DystopiaNow/UVCLamps_chambers/IMG_20200504_171959.jpg

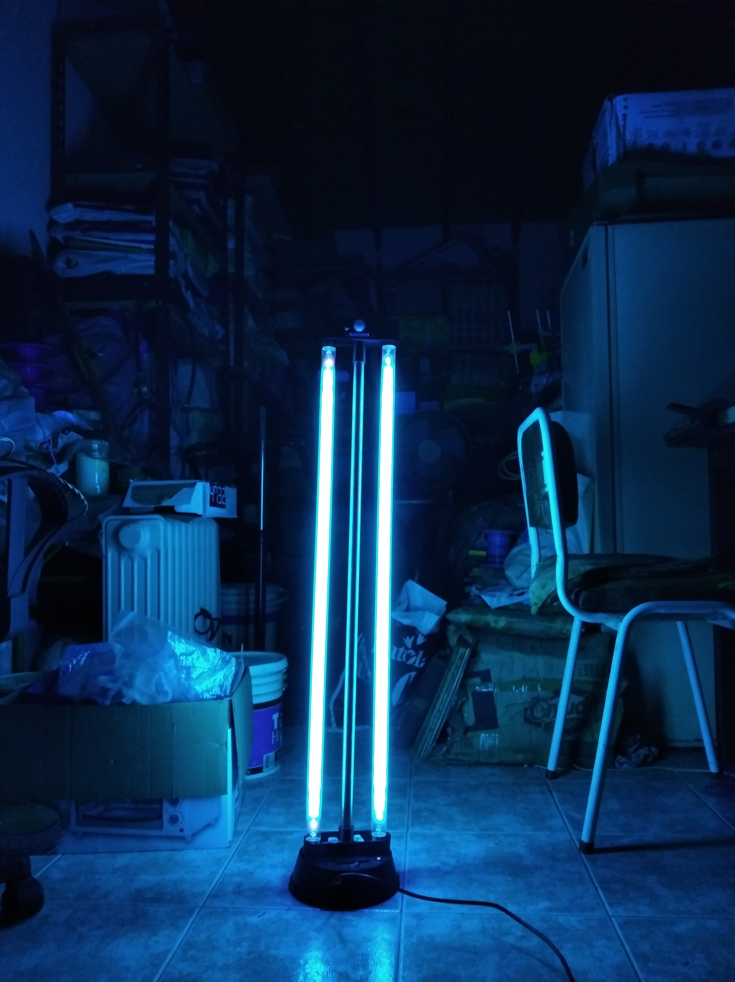
IMG_20200504_171959.jpg
