DystopiaNow/UVCLamps_chambers/UVCChamber1/Captura de pantalla 2020-05-08 20.49.10.png

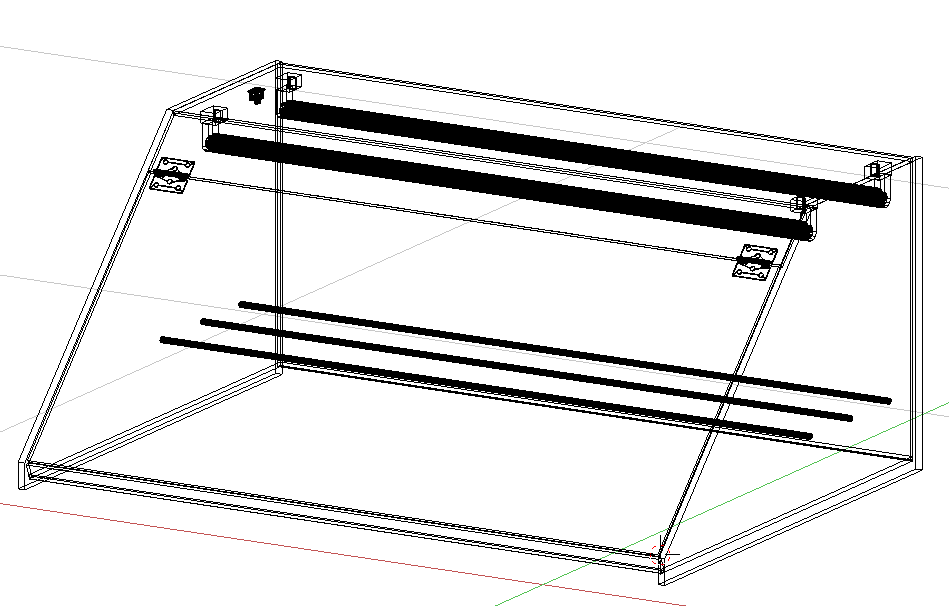
UVCChamber1/Captura de pantalla 2020-05-08 20.49.10.png
