DystopiaNow/UVCLamps_chambers/UVCChamber1/Captura de pantalla 2020-05-09 03.30.54.png

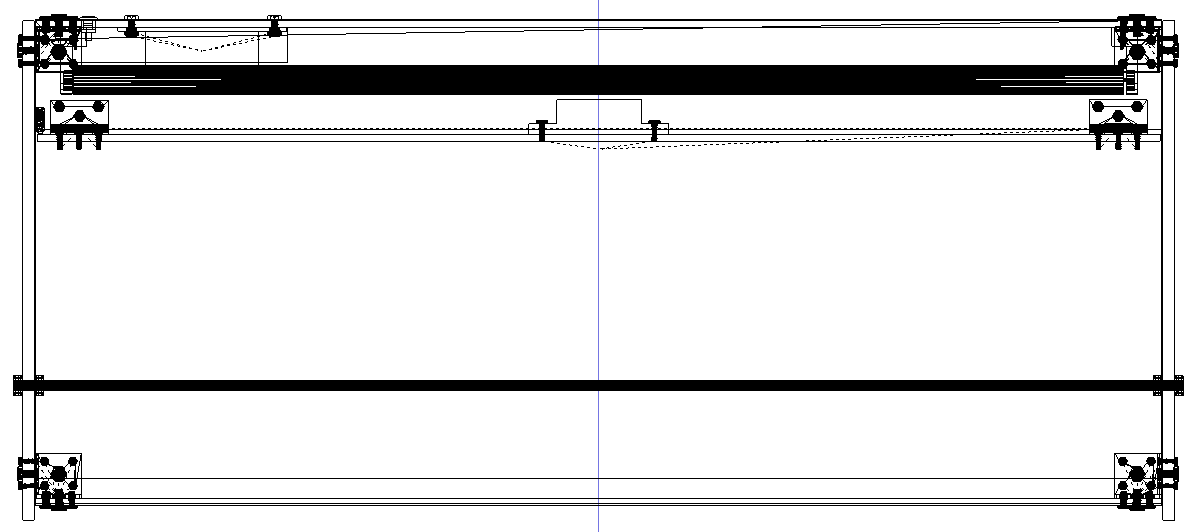
UVCChamber1/Captura de pantalla 2020-05-09 03.30.54.png
