DystopiaNow/UVCLamps_chambers/UVCChamber1/UVC_chamber1.png

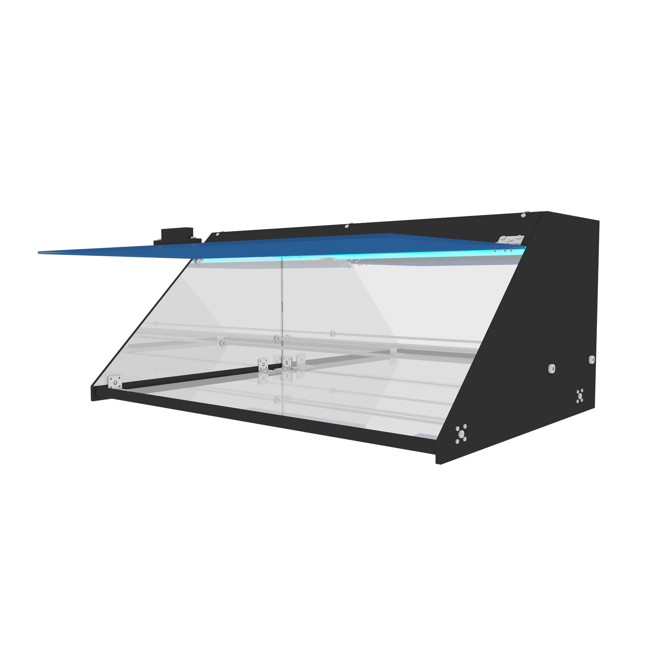
UVCChamber1/UVC_chamber1.png
