DystopiaNow/UVCLamps_chambers/UVCChamber1/UVC_chamber2.png

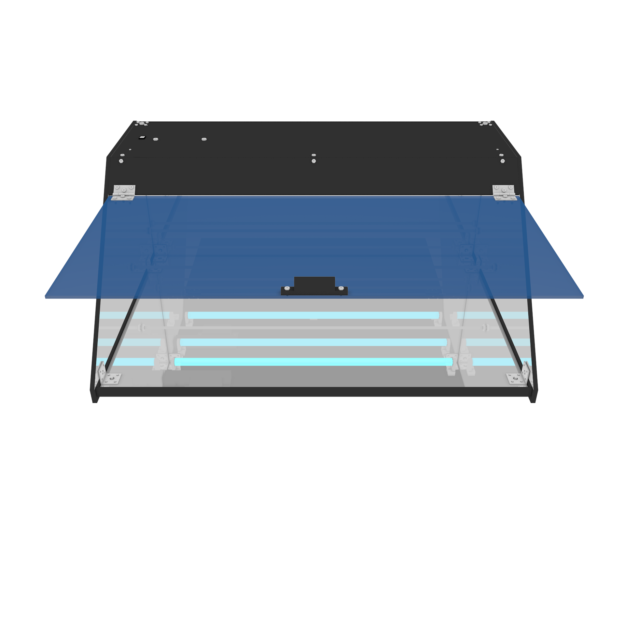
UVCChamber1/UVC_chamber2.png
