DystopiaNow/UVCLamps_chambers/UVCChamber1/UVC_chamber3.png

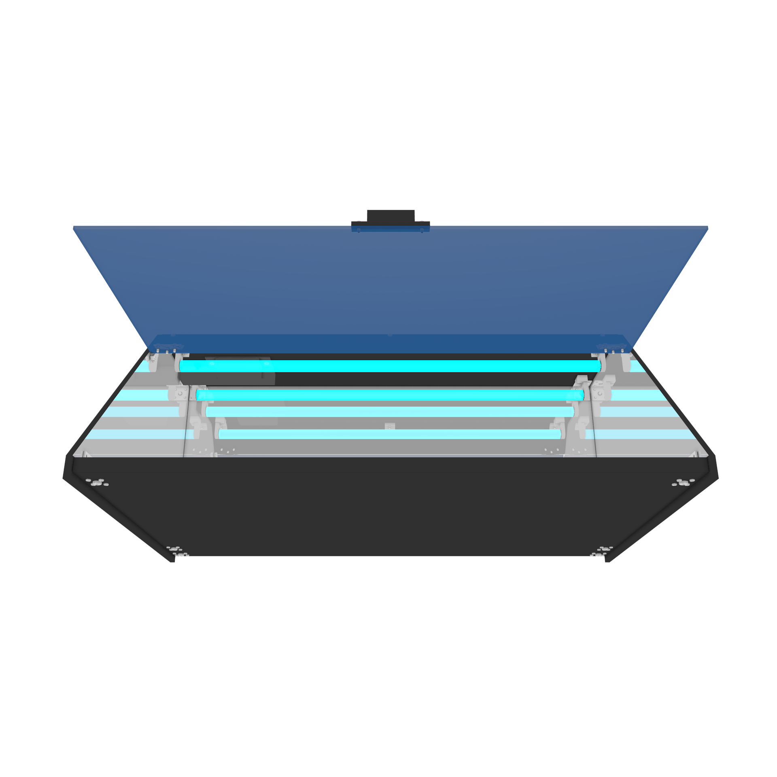
UVCChamber1/UVC_chamber3.png
