DystopiaNow/UVCLamps_chambers/UVCChamber1/UVC_chamber4.png

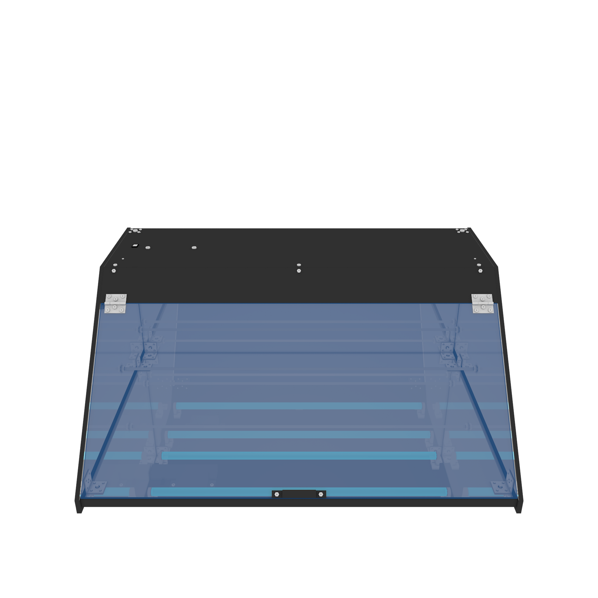
UVCChamber1/UVC_chamber4.png
