DystopiaNow/UVCLamps_chambers/UVCChamber1/UVC_chamber5.png

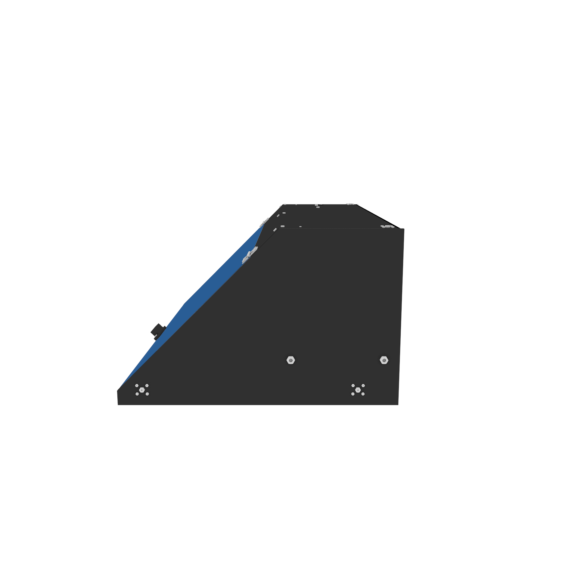
UVCChamber1/UVC_chamber5.png
