DystopiaNow/UVCLamps_chambers/UVCChamber1/UVC_chamber6.png

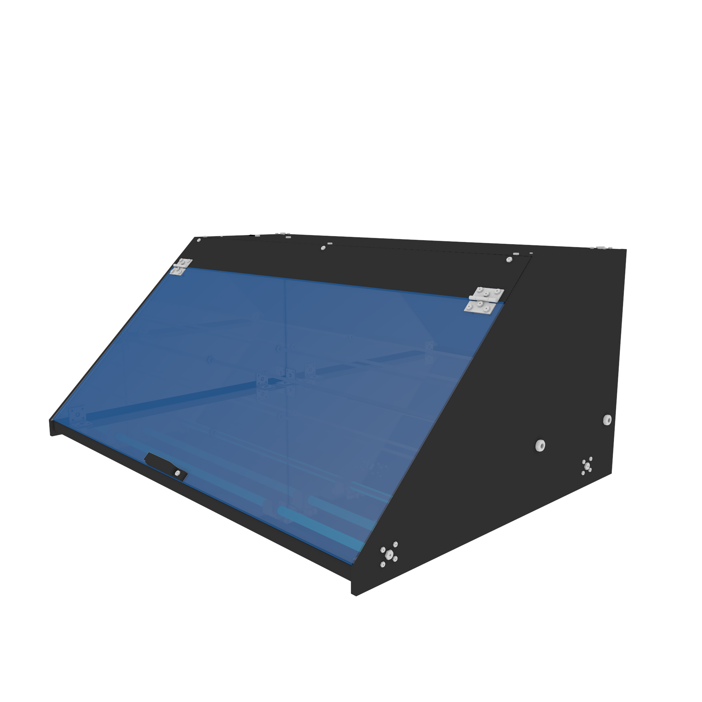
UVCChamber1/UVC_chamber6.png
