DystopiaNow/UVCLamps_chambers/UVCChamber1/UVC_chamber7.png

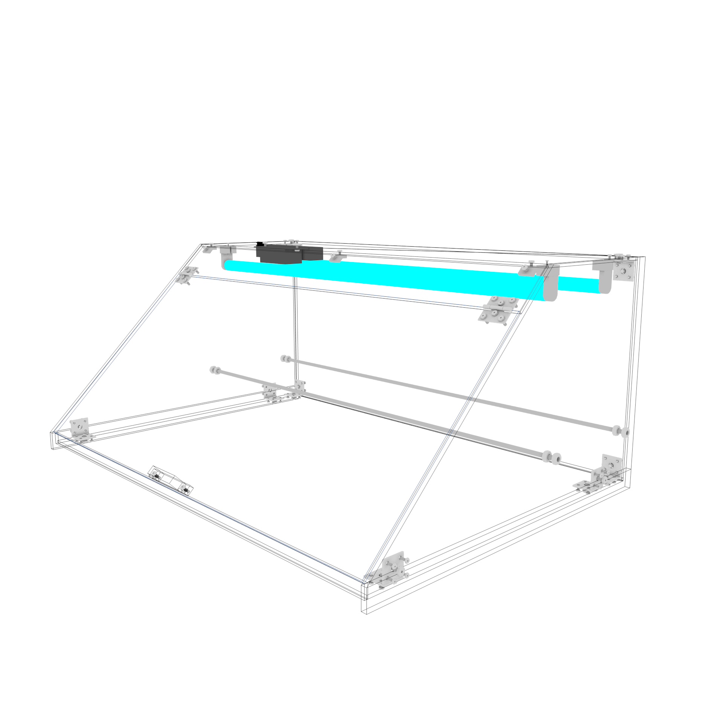
UVCChamber1/UVC_chamber7.png
