DystopiaNow/UVCLamps_chambers/UVCChamber1/UVC_chamber8.png

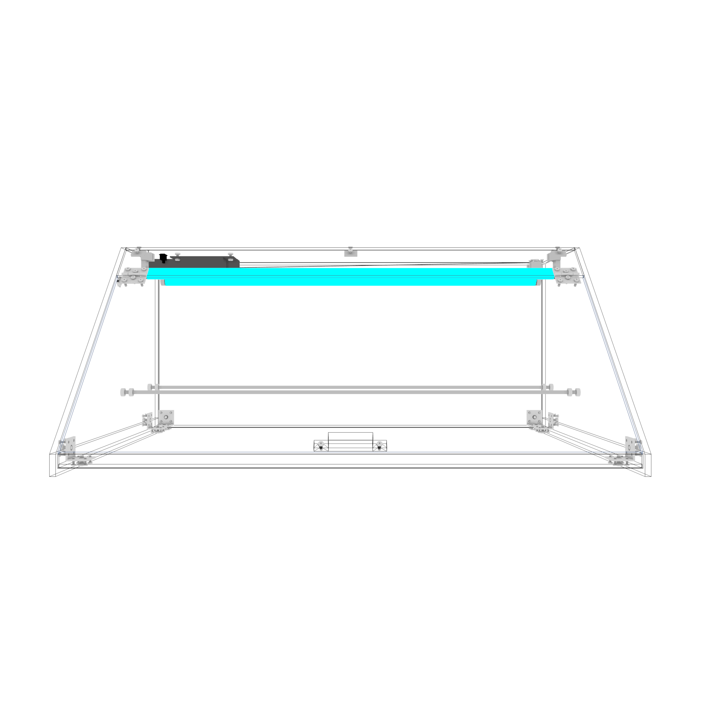
UVCChamber1/UVC_chamber8.png
