DystopiaNow/UVCLamps_chambers/UVCChamber1/UVC_chamber9.png

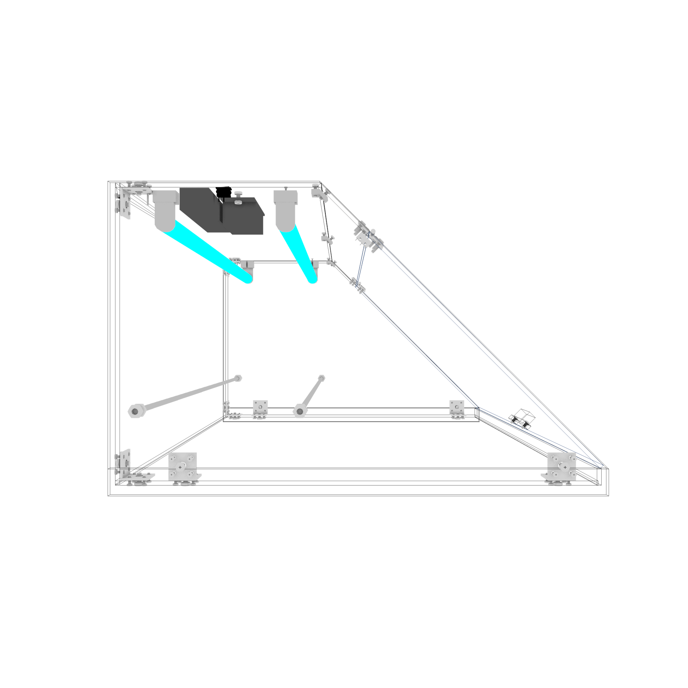
UVCChamber1/UVC_chamber9.png
