DystopiaNow/UVCLamps_chambers/UVCChamber1/UVC_chamber10.png

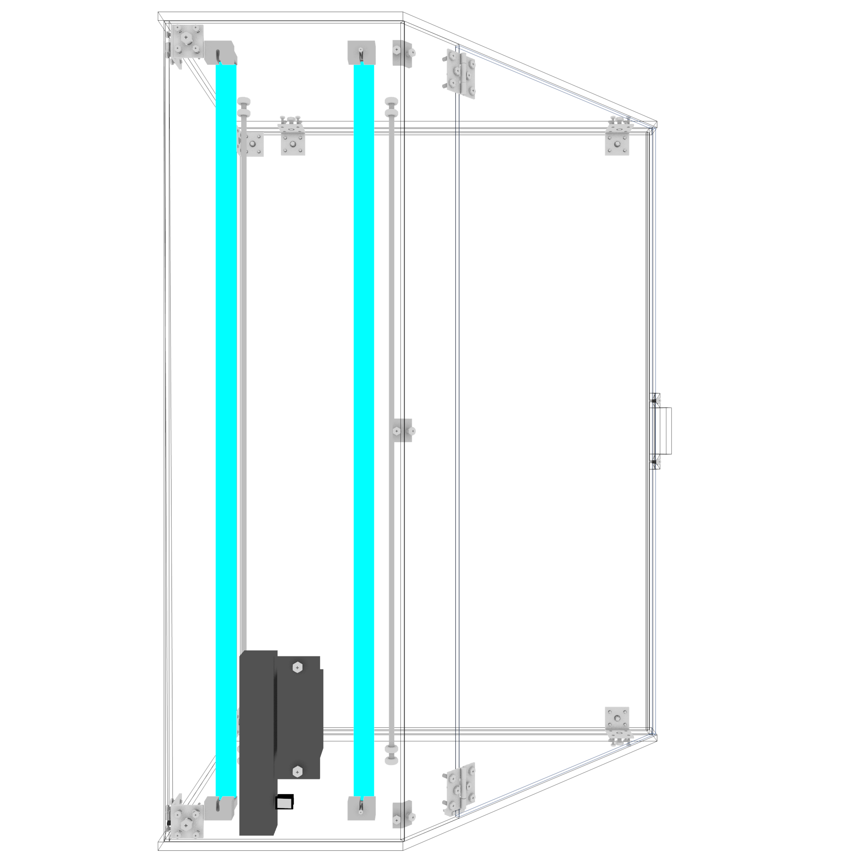
UVCChamber1/UVC_chamber10.png
