DystopiaNow/UVCLamps_chambers/UVCChamber1/UVC_chamber11.png

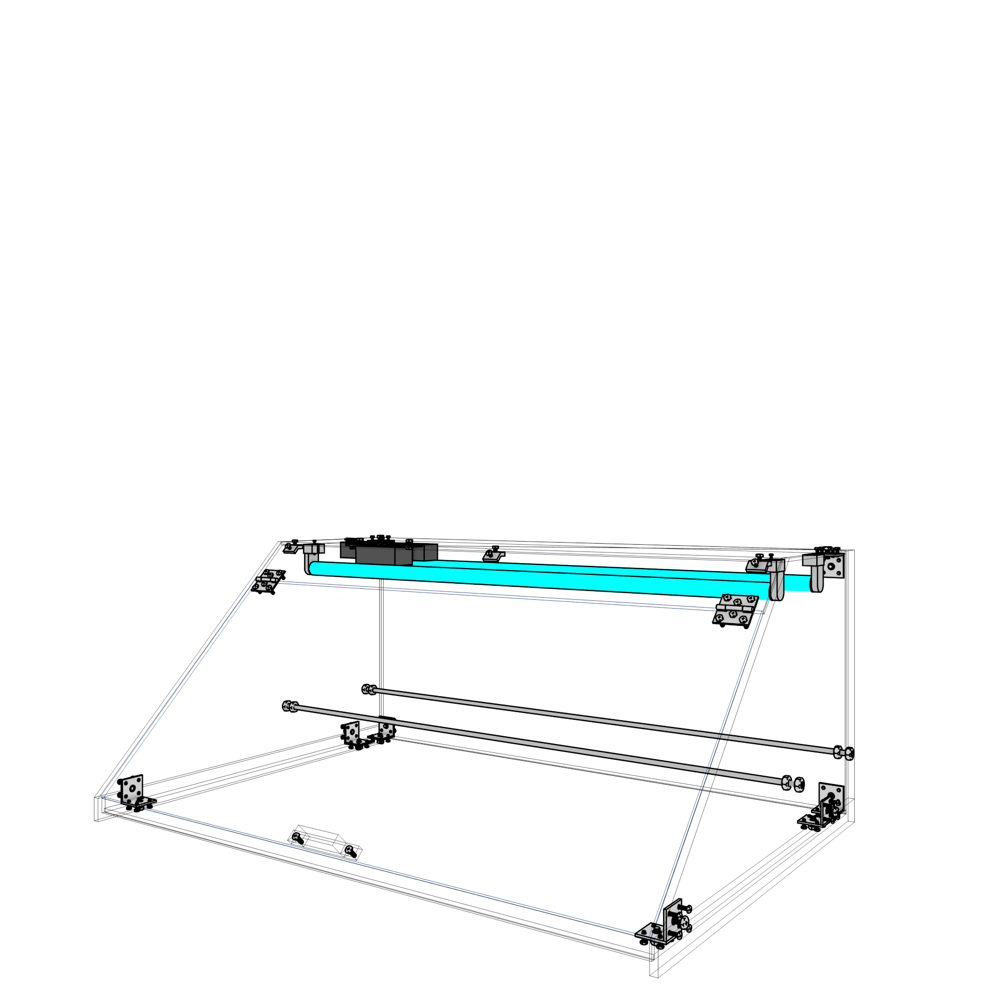
UVCChamber1/UVC_chamber11.png
