DystopiaNow/UVCLamps_chambers/UVCChamber1/UVC_chamberV2_1.png

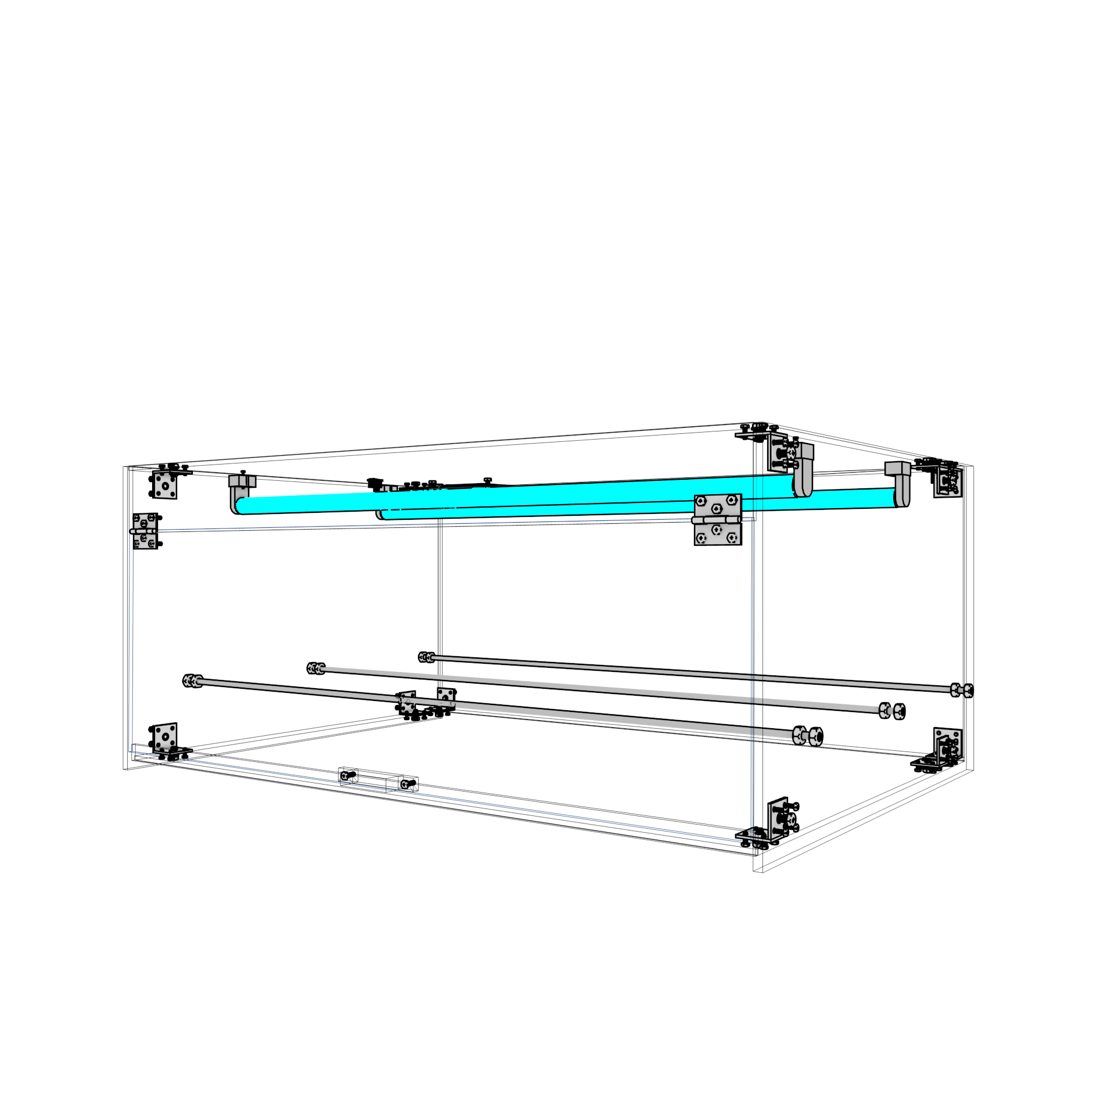
UVCChamber1/UVC_chamberV2_1.png
