DystopiaNow/UVCLamps_chambers/UVCChamber1/UVC_chamberV2_8.png

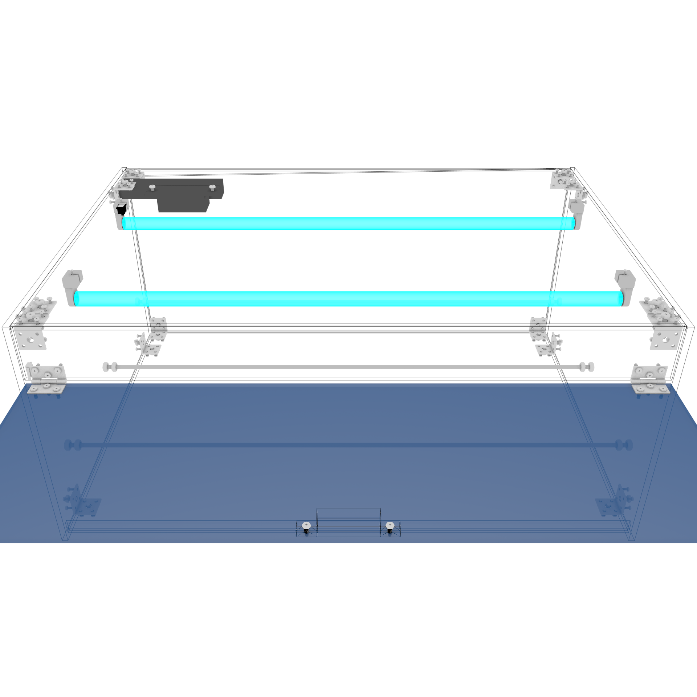
UVCChamber1/UVC_chamberV2_8.png
