DystopiaNow/UVCLamps_chambers/UVCChamber1/UVC_chamberV2_9.png

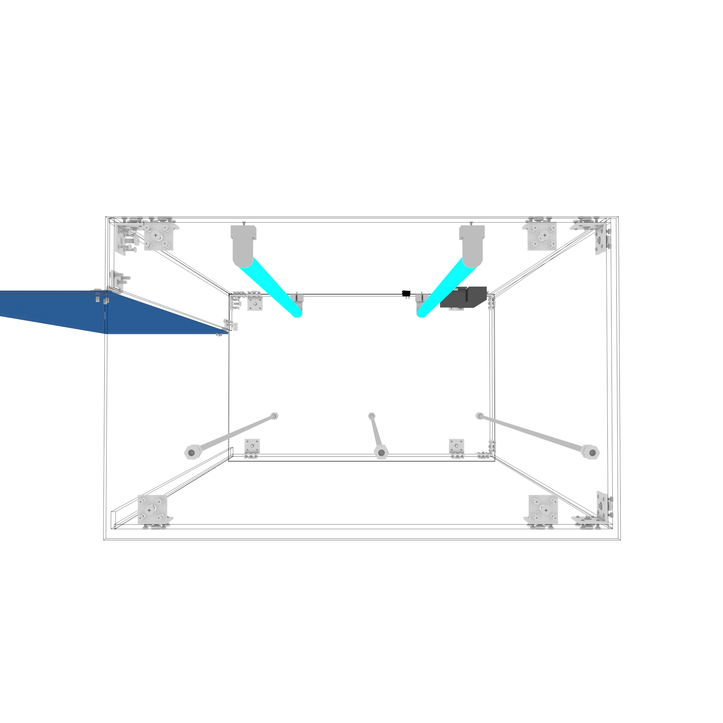
UVCChamber1/UVC_chamberV2_9.png
