DystopiaNow/UVCLamps_chambers/UVCChamber1/UVCCHAMBER_1_MEDIDAS1.png

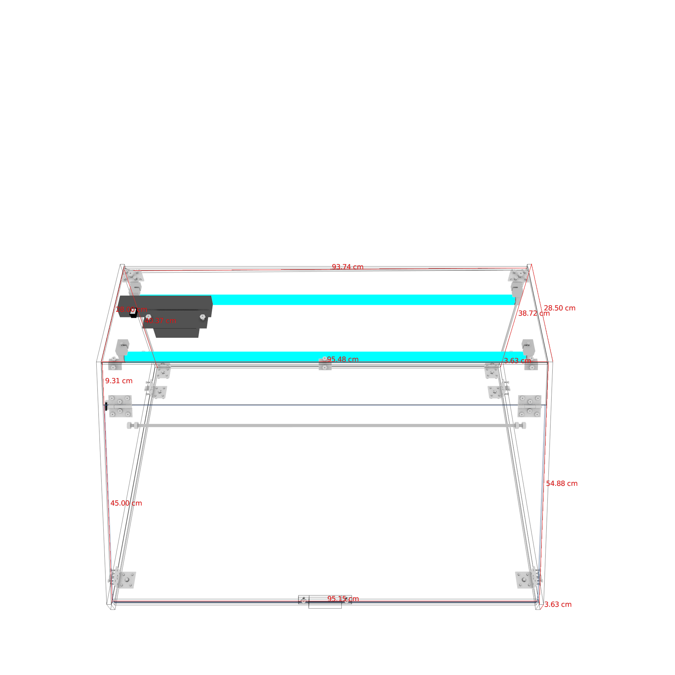
UVCChamber1/UVCCHAMBER_1_MEDIDAS1.png
