DystopiaNow/UVCLamps_chambers/UVCChamber1/UVCHAMBER_1_MEDIDAS1.png

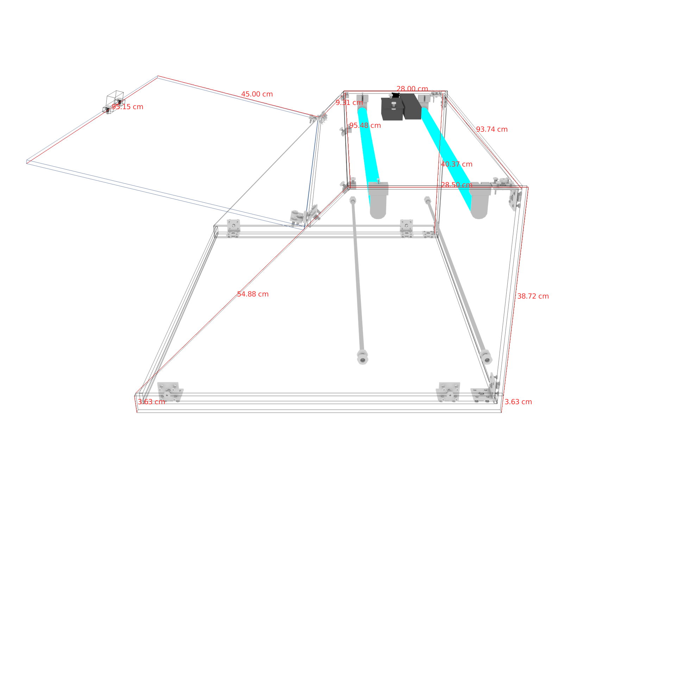
UVCChamber1/UVCHAMBER_1_MEDIDAS1.png
