DystopiaNow/UVCLamps_chambers/UVCChamber1/UVCHAMBER_2_Medidas1.png

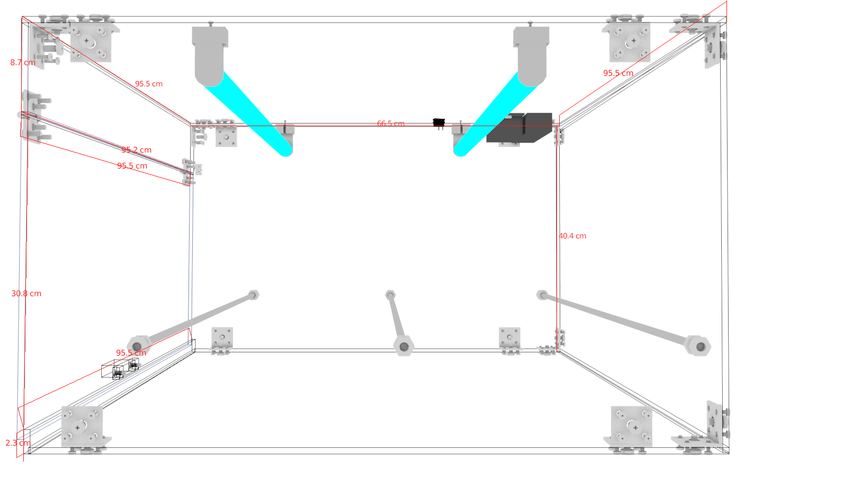
UVCChamber1/UVCHAMBER_2_Medidas1.png
