DystopiaNow/UVCLamps_chambers/UVCChamber1/UVCHAMBER__2_MEDIDAS3.png

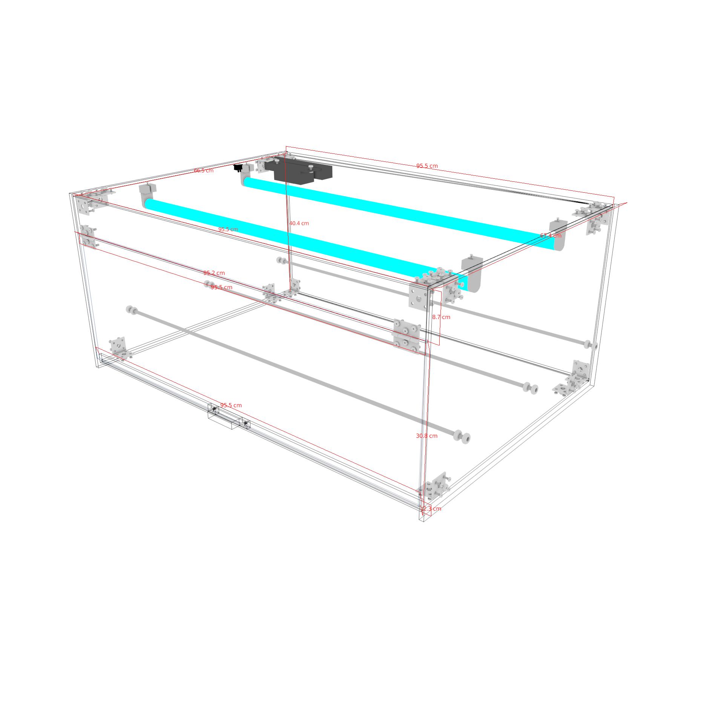
UVCChamber1/UVCHAMBER__2_MEDIDAS3.png
