DystopiaNow/UVCLamps_chambers/UVCChamber1/UVCHAMBER_MEDIDAS2.png

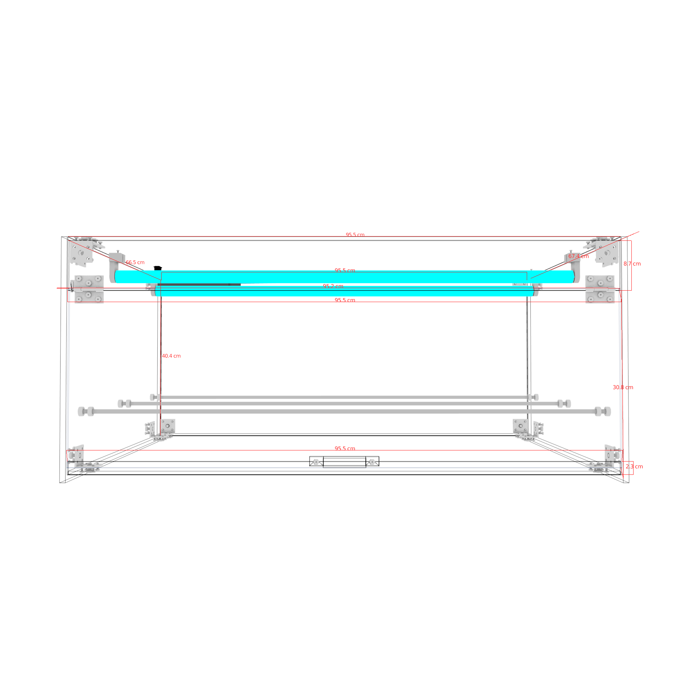
UVCChamber1/UVCHAMBER_MEDIDAS2.png
