DystopiaNow/UVCLamps_chambers/Ensamble.stl

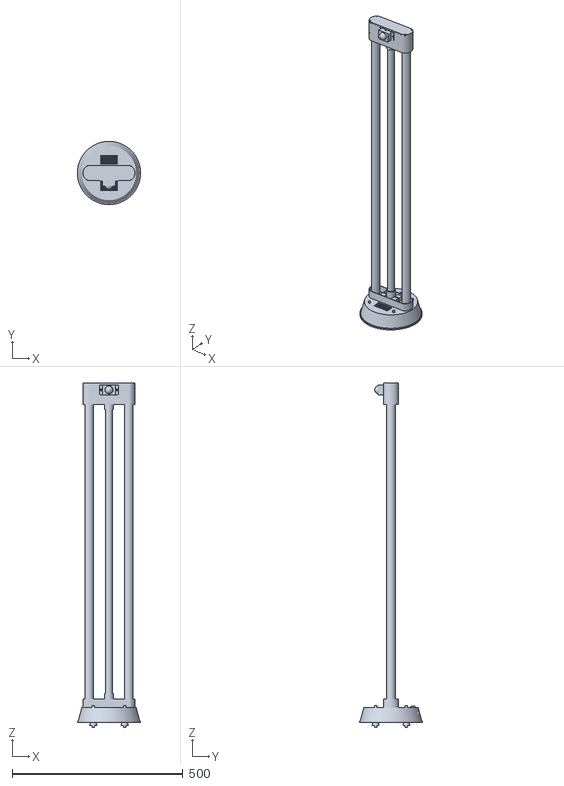
[picture p52: CAD file, 2021-02-09]
Ensamble.stl
185.1 x 185.1 x 1009.1
