DystopiaNow/UVCLamps_chambers/UVC_LUZ_COBERTOR.stl

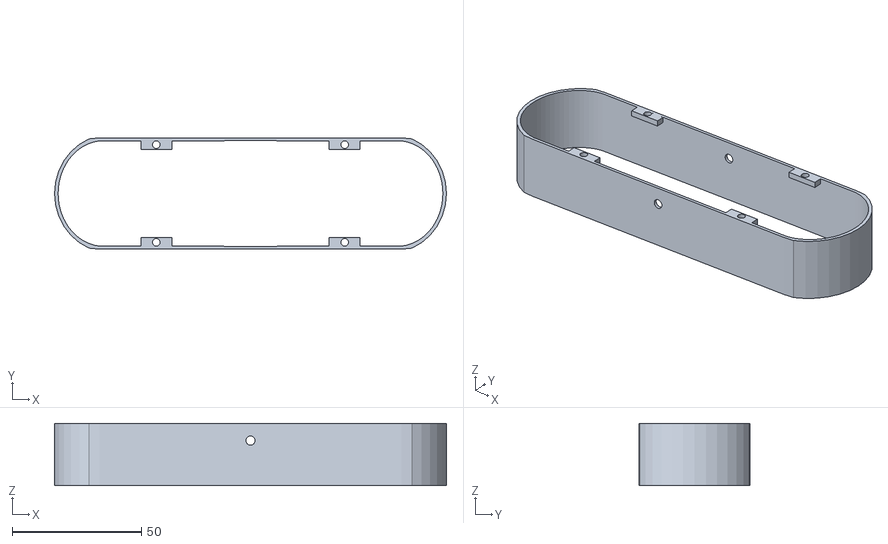
[picture p53: CAD file, 2021-02-09]
UVC_LUZ_COBERTOR.stl
151.9 x 43.2 x 24.1
