DystopiaNow/UVCLamps_chambers/UVChamberPortable/UVC_chamber_cobertor_roscada.stl

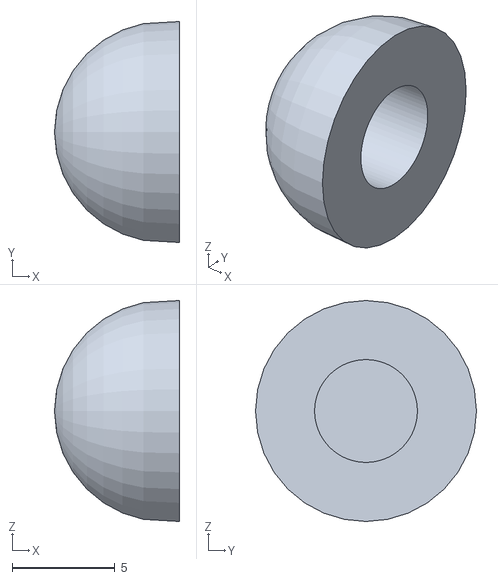
[picture p54: CAD file, 2021-02-09]
UVChamberPortable/UVC_chamber_cobertor_roscada.stl
6.08 x 10.7 x 10.7
