DystopiaNow/UVCLamps_chambers/UVC_LUZ_PIE.stl

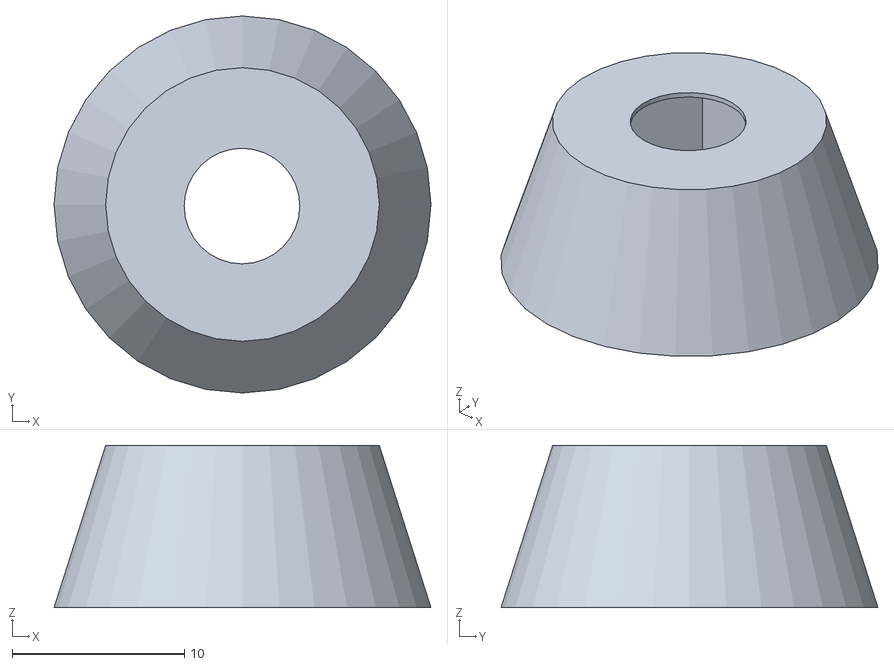
[picture p55: CAD file, 2021-02-09]
UVC_LUZ_PIE.stl
21.9 x 21.9 x 9.40
