DystopiaNow/UVCLamps_chambers/UVChamberPortable/UVC_Chamber_bisagra_puerta.stl

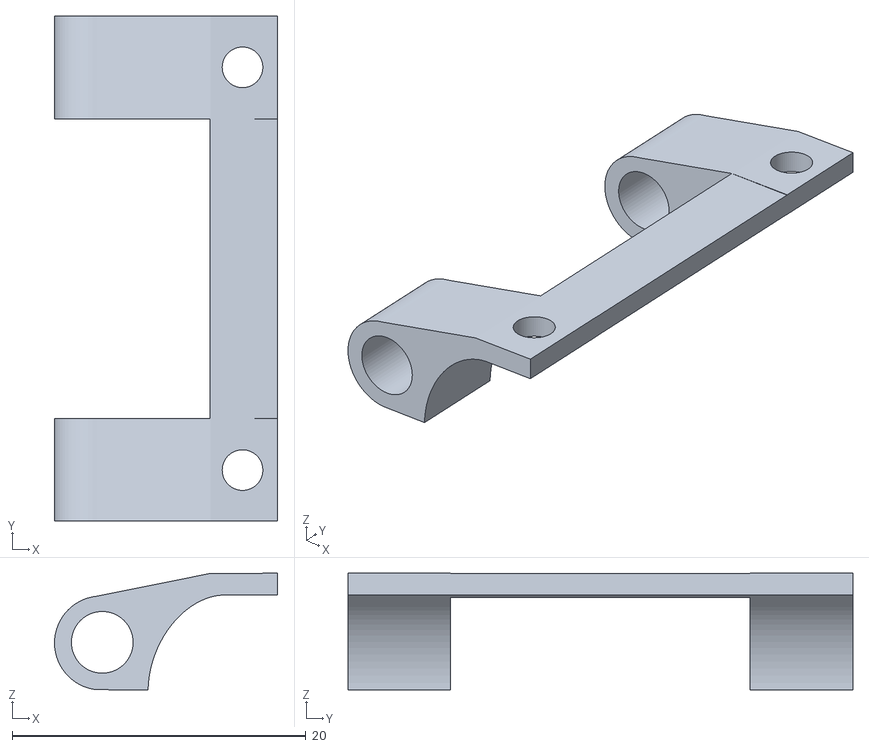
[picture p56: CAD file, 2021-02-09]
UVChamberPortable/UVC_Chamber_bisagra_puerta.stl
15.2 x 34.4 x 7.94
