DystopiaNow/UVCLamps_chambers/UVC_LUZ_Soporte_placas.stl

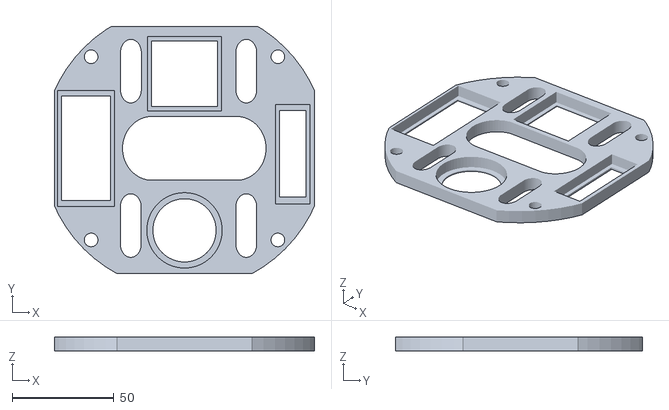
[picture p57: CAD file, 2021-02-09]
UVC_LUZ_Soporte_placas.stl
127.6 x 121.2 x 7.00
