DystopiaNow/UVCLamps_chambers/UVChamberPortable/UVC_chamber_case_electronica.stl

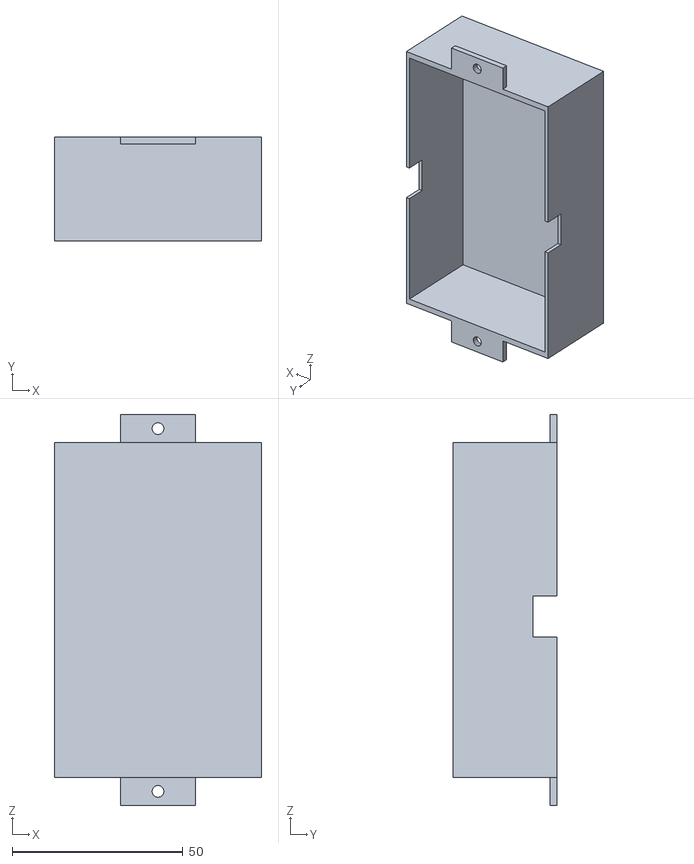
[picture p58: CAD file, 2021-02-09]
UVChamberPortable/UVC_chamber_case_electronica.stl
60.7 x 30.4 x 114.5
