DystopiaNow/UVCLamps_chambers/UVChamberPortable/UVC_Chamber_esqina_soporte_1.stl

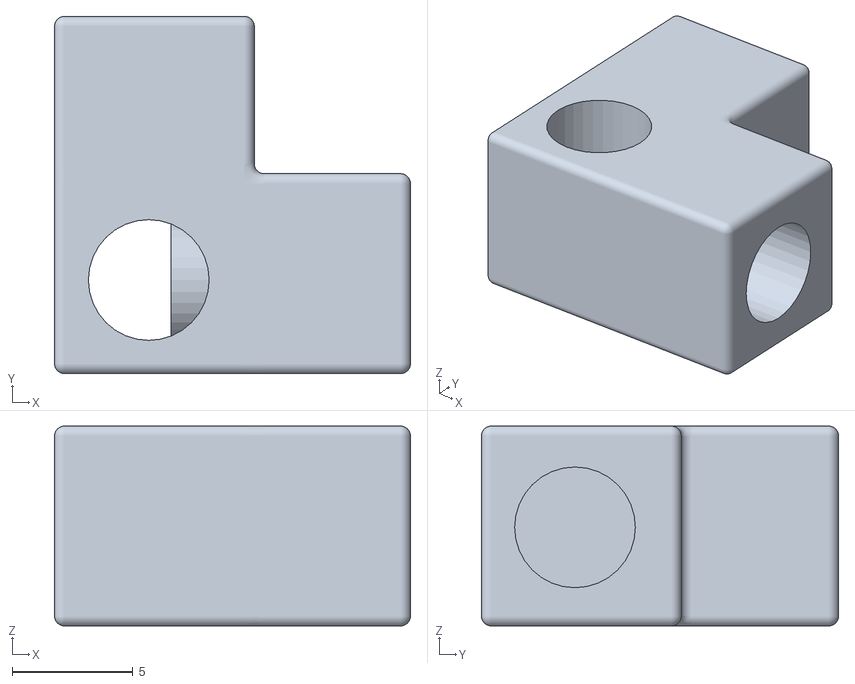
[picture p59: CAD file, 2021-02-09]
UVChamberPortable/UVC_Chamber_esqina_soporte_1.stl
14.7 x 14.8 x 8.28
