DystopiaNow/UVCLamps_chambers/UVC_LUZ_TAPA_BASE.stl

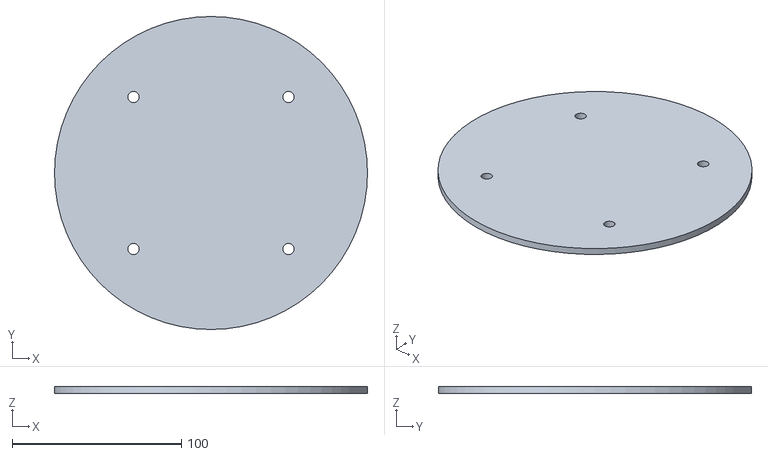
[picture p60: CAD file, 2021-02-09]
UVC_LUZ_TAPA_BASE.stl
185.1 x 185.1 x 4.00
