DystopiaNow/UVCLamps_chambers/UVChamberPortable/UVC_Chamber_esqina_soporte_2.stl

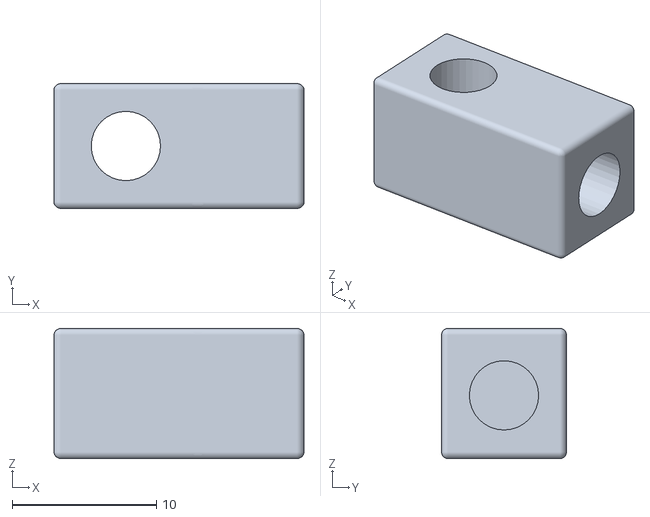
[picture p61: CAD file, 2021-02-09]
UVChamberPortable/UVC_Chamber_esqina_soporte_2.stl
17.3 x 8.65 x 9.01
