DystopiaNow/UVCLamps_chambers/UVC_LUZ_TAPA_SUP2.stl

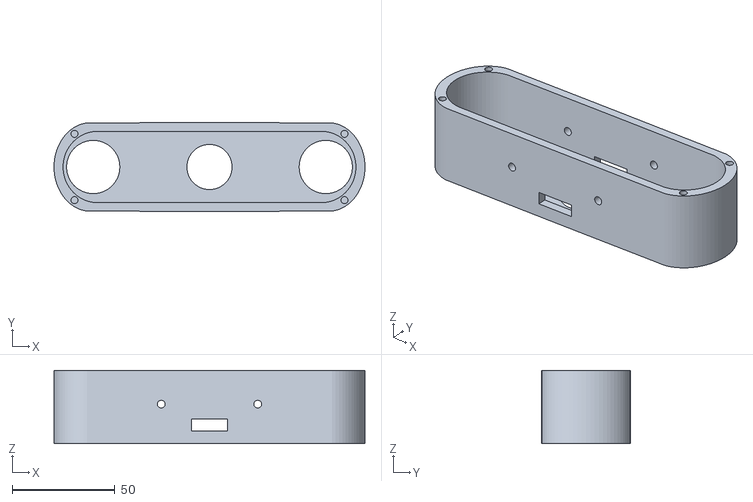
[picture p62: CAD file, 2021-02-09]
UVC_LUZ_TAPA_SUP2.stl
151.5 x 43.2 x 35.7
