DystopiaNow/UVCLamps_chambers/UVChamberPortable/ColumnaFix.stl

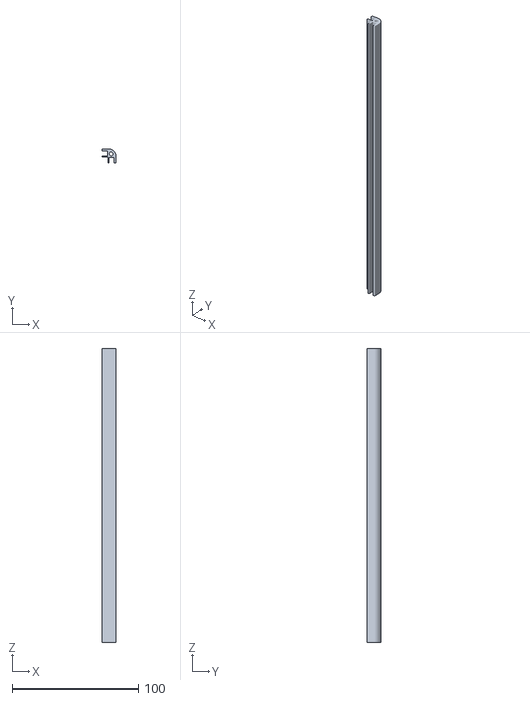
[picture p63: CAD file, 2021-02-09]
UVChamberPortable/ColumnaFix.stl
11.0 x 11.0 x 233.1
