DystopiaNow/UVCLamps_chambers/UVC_LUZ_AJUSTE_CAÑO.stl

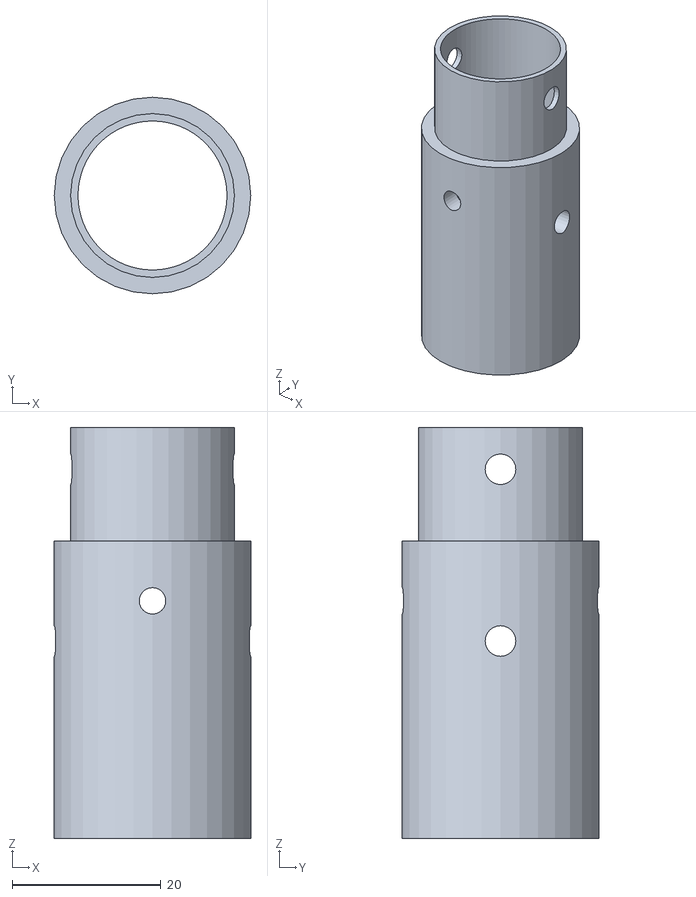
[picture p64: CAD file, 2021-02-09]
UVC_LUZ_AJUSTE_CAÑO.stl
26.4 x 26.4 x 55.2
