DystopiaNow/UVCLamps_chambers/UVChamberPortable/UVC_chamber_tapa_mdf_sin_bisagras.stl

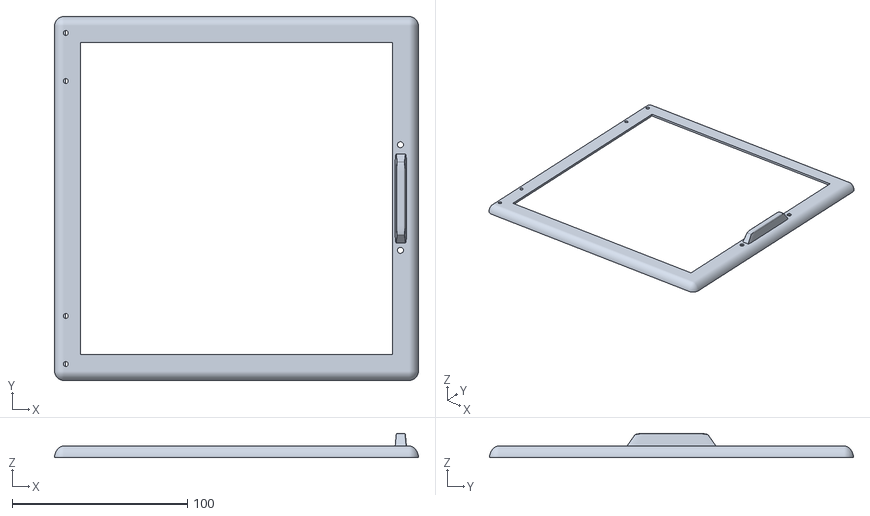
[picture p65: CAD file, 2021-02-09]
UVChamberPortable/UVC_chamber_tapa_mdf_sin_bisagras.stl
207.4 x 207.4 x 13.8
