DystopiaNow/UVCLamps_chambers/UVC_LUZ_PIRSUPPORT.stl

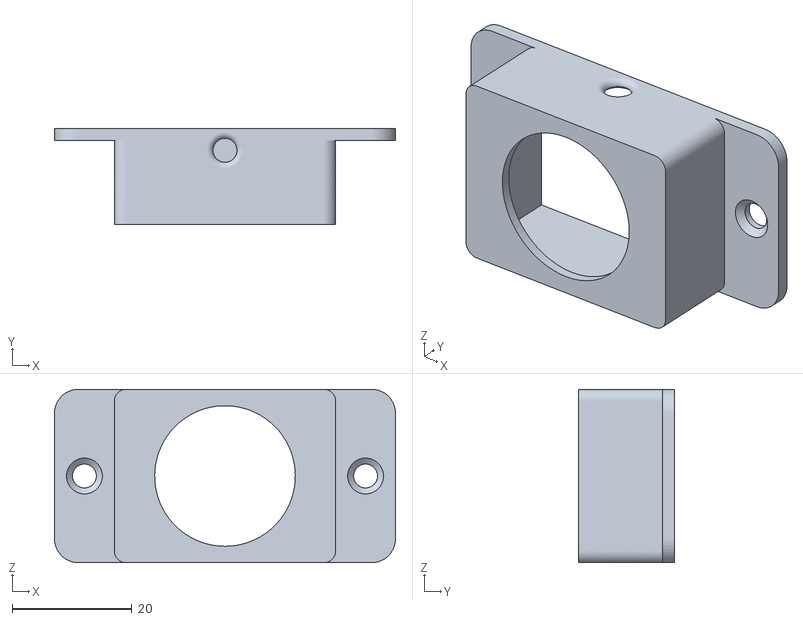
[picture p66: CAD file, 2021-02-09]
UVC_LUZ_PIRSUPPORT.stl
57.0 x 16.0 x 29.0
