DystopiaNow/UVCLamps_chambers/UVChamberPortable/UVC_chamber_bisagra.stl

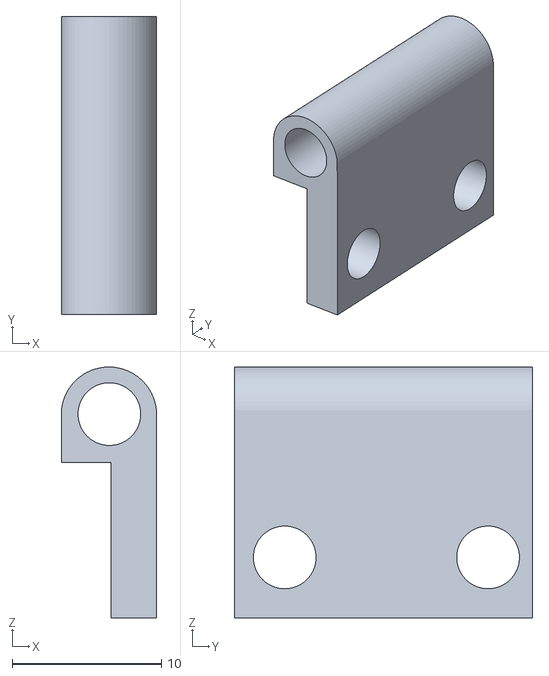
[picture p67: CAD file, 2021-02-09]
UVChamberPortable/UVC_chamber_bisagra.stl
6.39 x 20.0 x 16.8
