DystopiaNow/UVCLamps_chambers/UVC_LUZ_ESPACIADOR_TORNILLO_6MM.stl

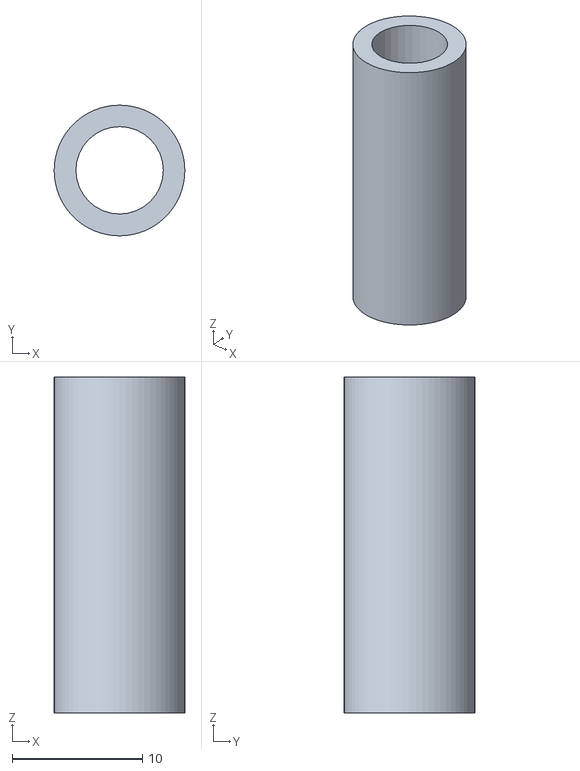
[picture p68: CAD file, 2021-02-09]
UVC_LUZ_ESPACIADOR_TORNILLO_6MM.stl
10.0 x 10.0 x 25.8
