DystopiaNow/UVCLamps_chambers/UVChamberPortable/UVC_chamber_cobertor_Luz.stl

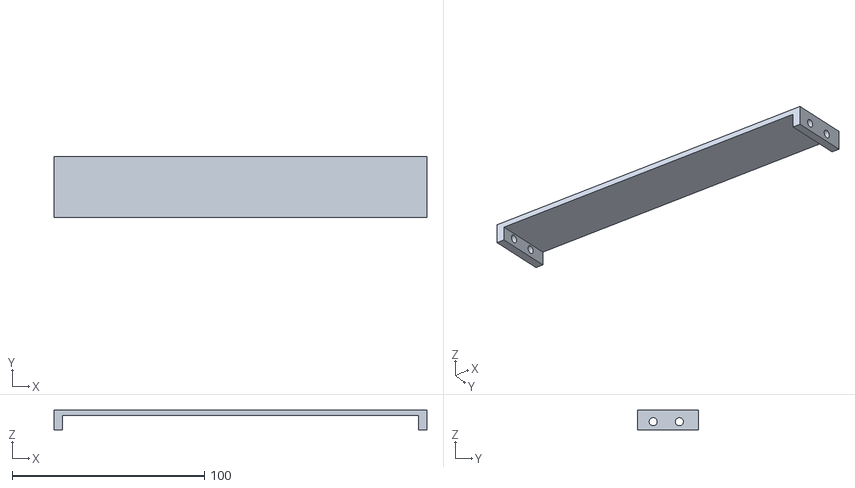
[picture p69: CAD file, 2021-02-09]
UVChamberPortable/UVC_chamber_cobertor_Luz.stl
194.1 x 31.9 x 10.4
