DystopiaNow/UVCLamps_chambers/UVC_LUZ_FIXREJILLA.stl

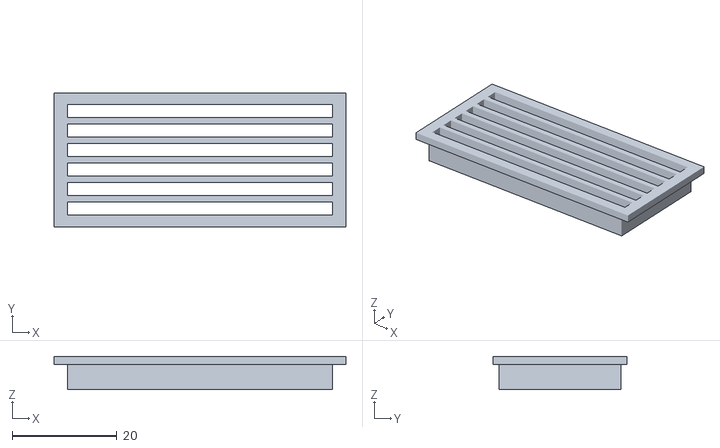
[picture p70: CAD file, 2021-02-09]
UVC_LUZ_FIXREJILLA.stl
55.8 x 25.7 x 6.33
