DystopiaNow/UVCLamps_chambers/UVChamberPortable/UVC_CHamber_anclaje_puerta_mdf.stl

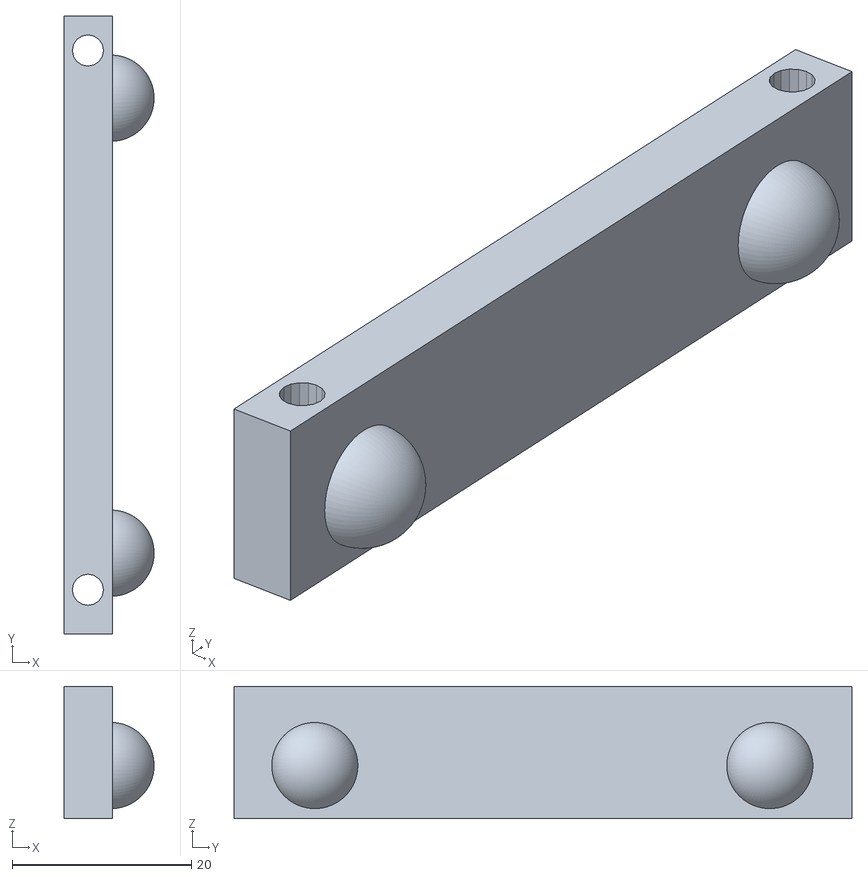
[picture p71: CAD file, 2021-02-09]
UVChamberPortable/UVC_CHamber_anclaje_puerta_mdf.stl
10.1 x 69.0 x 14.8
