DystopiaNow/UVCLamps_chambers/Fluorescente.stl

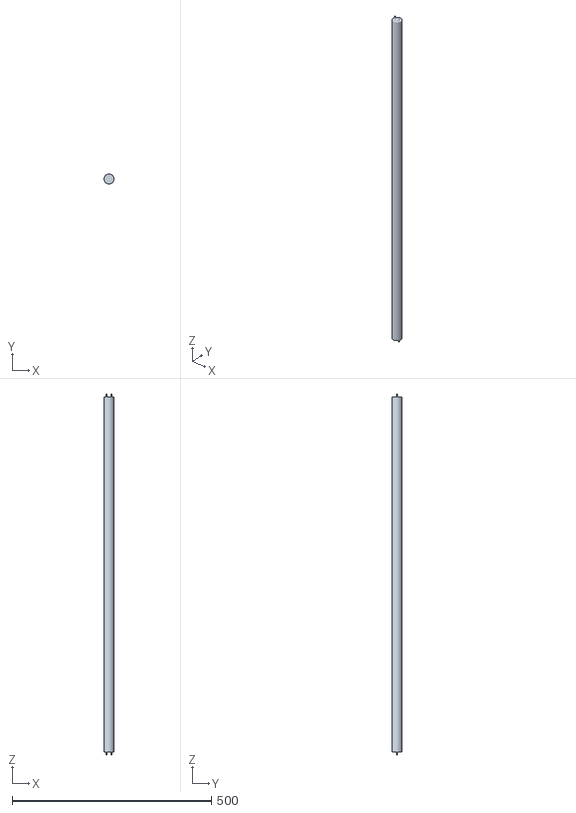
[picture p72: CAD file, 2021-02-09]
Fluorescente.stl
25.0 x 25.0 x 905.8
