DystopiaNow/UVCLamps_chambers/UVChamberPortable/Medio_repisa_varilla_5rmm.stl

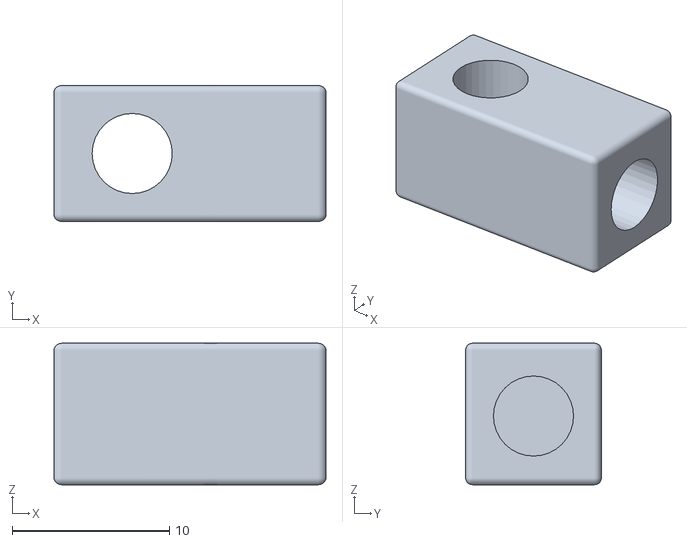
[picture p73: CAD file, 2021-02-09]
UVChamberPortable/Medio_repisa_varilla_5rmm.stl
17.3 x 8.65 x 9.01
