DystopiaNow/UVCLamps_chambers/UVC_LUZ_TAPA_SUP1.stl

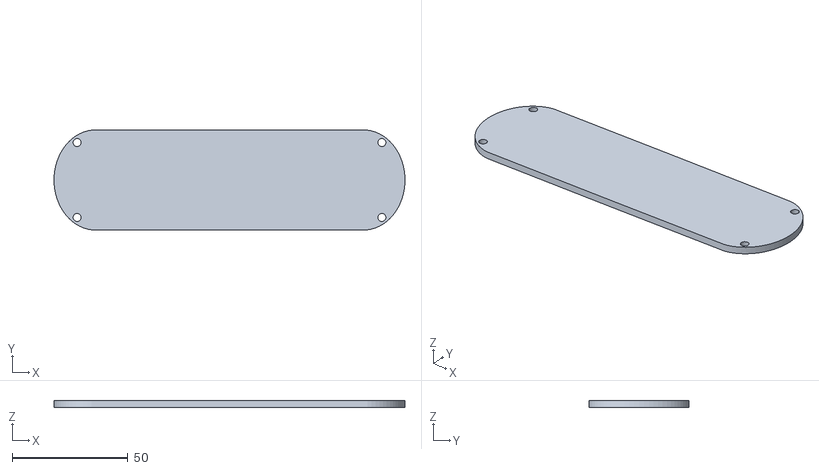
[picture p74: CAD file, 2021-02-09]
UVC_LUZ_TAPA_SUP1.stl
151.5 x 43.2 x 3.00
