DystopiaNow/UVCLamps_chambers/UVChamberPortable/Adaptador_tecla.stl

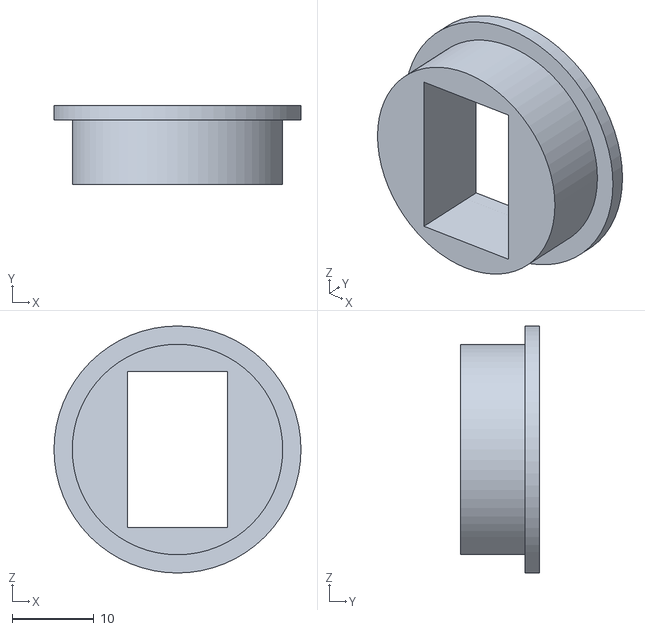
[picture p75: CAD file, 2021-02-09]
UVChamberPortable/Adaptador_tecla.stl
30.2 x 9.68 x 30.2
