DystopiaNow/UVCLamps_chambers/UVC_LUZ_BASE1.stl

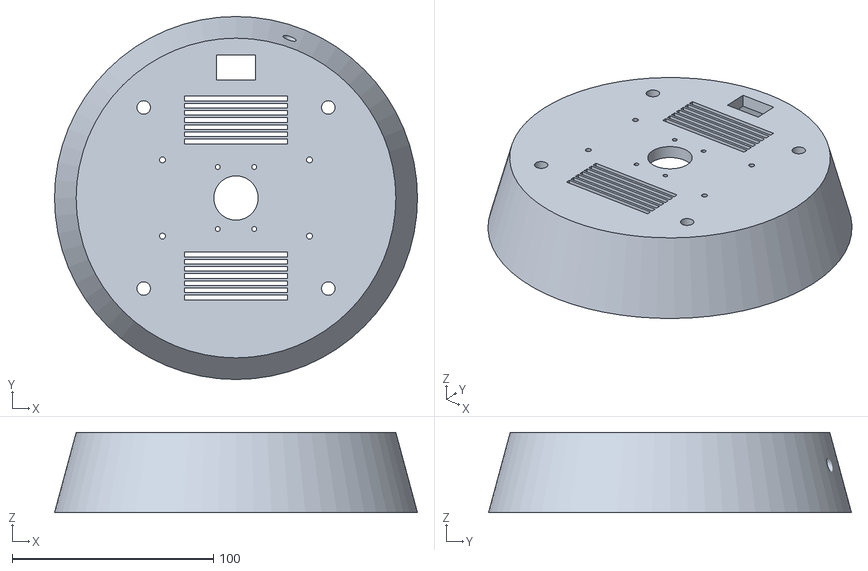
[picture p76: CAD file, 2021-02-09]
UVC_LUZ_BASE1.stl
180.3 x 180.3 x 39.9
