DystopiaNow/UVCLamps_chambers/UVChamberPortable/UVC_chamber_enganche_fluorescente.stl

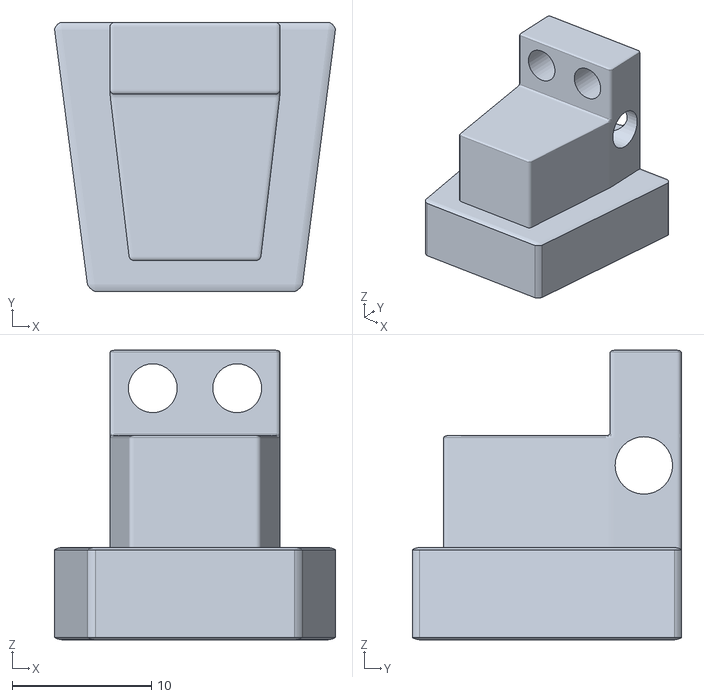
[picture p77: CAD file, 2021-02-09]
UVChamberPortable/UVC_chamber_enganche_fluorescente.stl
20.2 x 19.3 x 20.8
