DystopiaNow/UVCLamps_chambers/UVChamberPortable/UVC_chamber_pata.stl

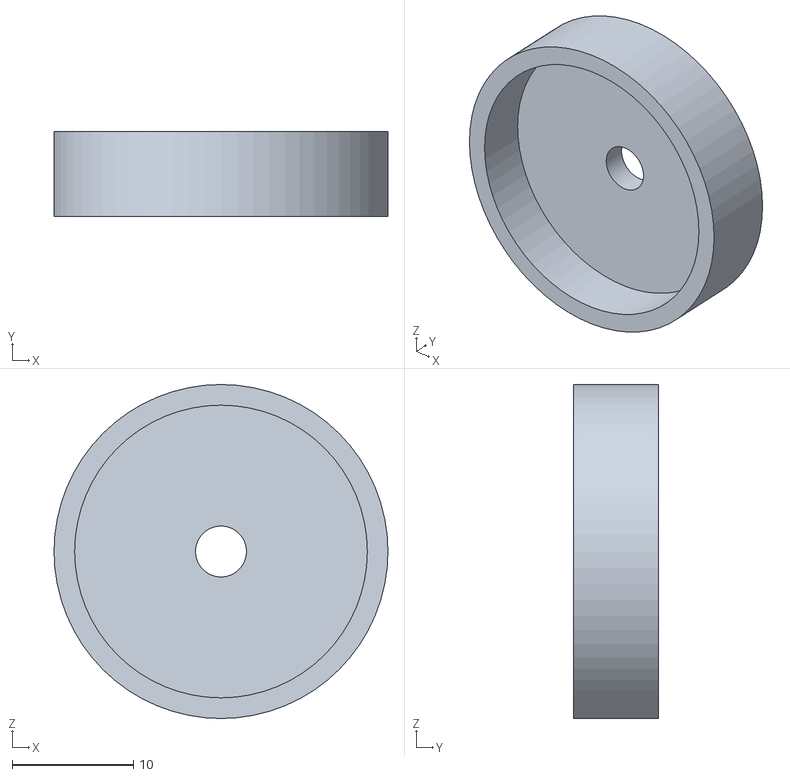
[picture p78: CAD file, 2021-02-09]
UVChamberPortable/UVC_chamber_pata.stl
27.6 x 7.00 x 27.6
