DystopiaNow/UVCLamps_chambers/UVChamberPortable/Marco_delantero_fix.stl

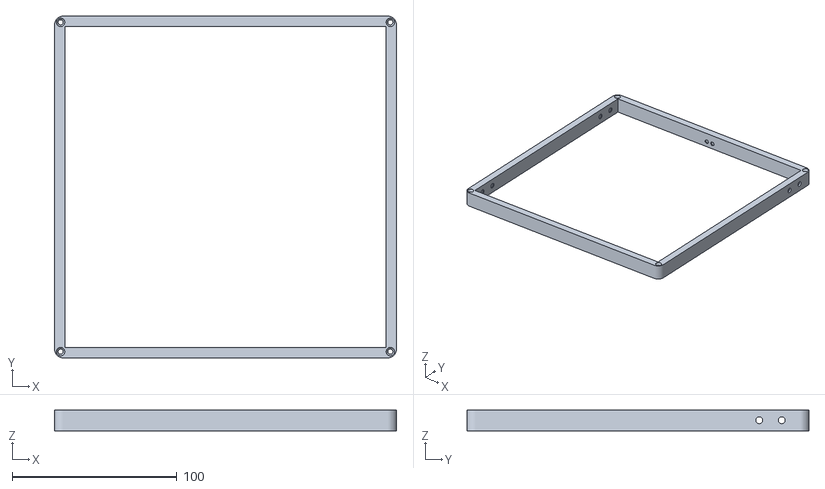
[picture p79: CAD file, 2021-02-09]
UVChamberPortable/Marco_delantero_fix.stl
207.4 x 207.4 x 12.7
