DystopiaNow/UVCLamps_chambers/UVChamberPortable/Traba_tapa_fix.stl

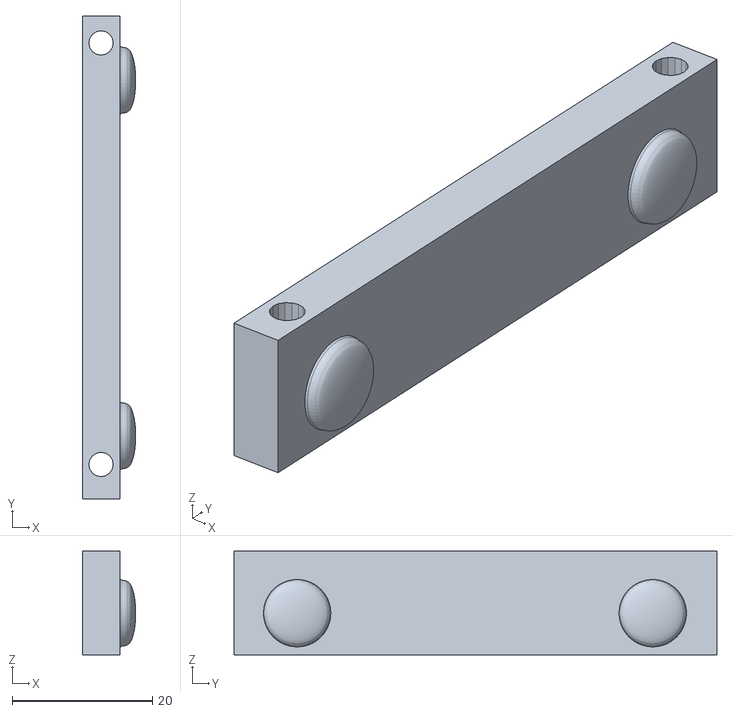
[picture p80: CAD file, 2021-02-09]
UVChamberPortable/Traba_tapa_fix.stl
7.63 x 69.0 x 14.8
