DystopiaNow/UVCLamps_chambers/UVChamberPortable/ColumnaFix4.stl

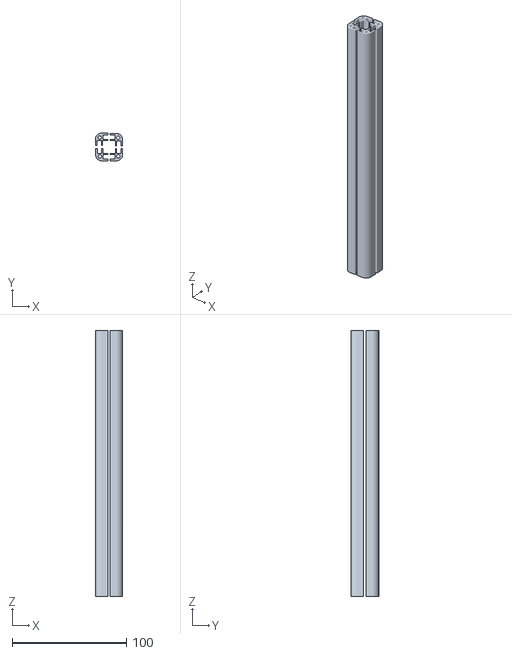
[picture p81: CAD file, 2021-02-09]
UVChamberPortable/ColumnaFix4.stl
24.0 x 24.3 x 233.1
