DystopiaNow/UVCLamps_chambers/UVChamberPortable/Tapa_posterior.stl

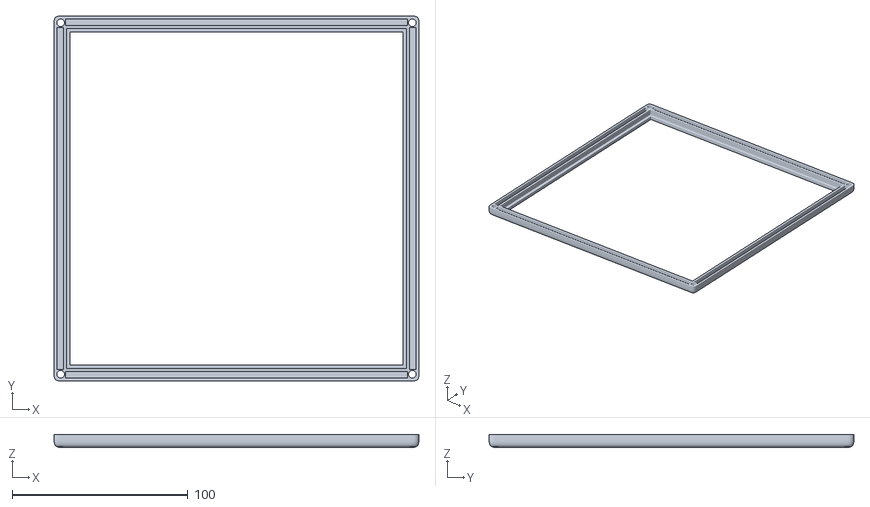
[picture p82: CAD file, 2021-02-09]
UVChamberPortable/Tapa_posterior.stl
207.4 x 207.4 x 7.31
