DystopiaNow/UVCLamps_chambers/(list of files, cad)

Other CAD files:
UVChamberPortable/Esquina_repisa_varilla_5rmm.stl
